yusufkarabocekz/bldc-motor-driver/BLDC Motor Driver.kicad_pcb

## KiCad design BLDC Motor Driver.kicad_pcb (2025-06-13)

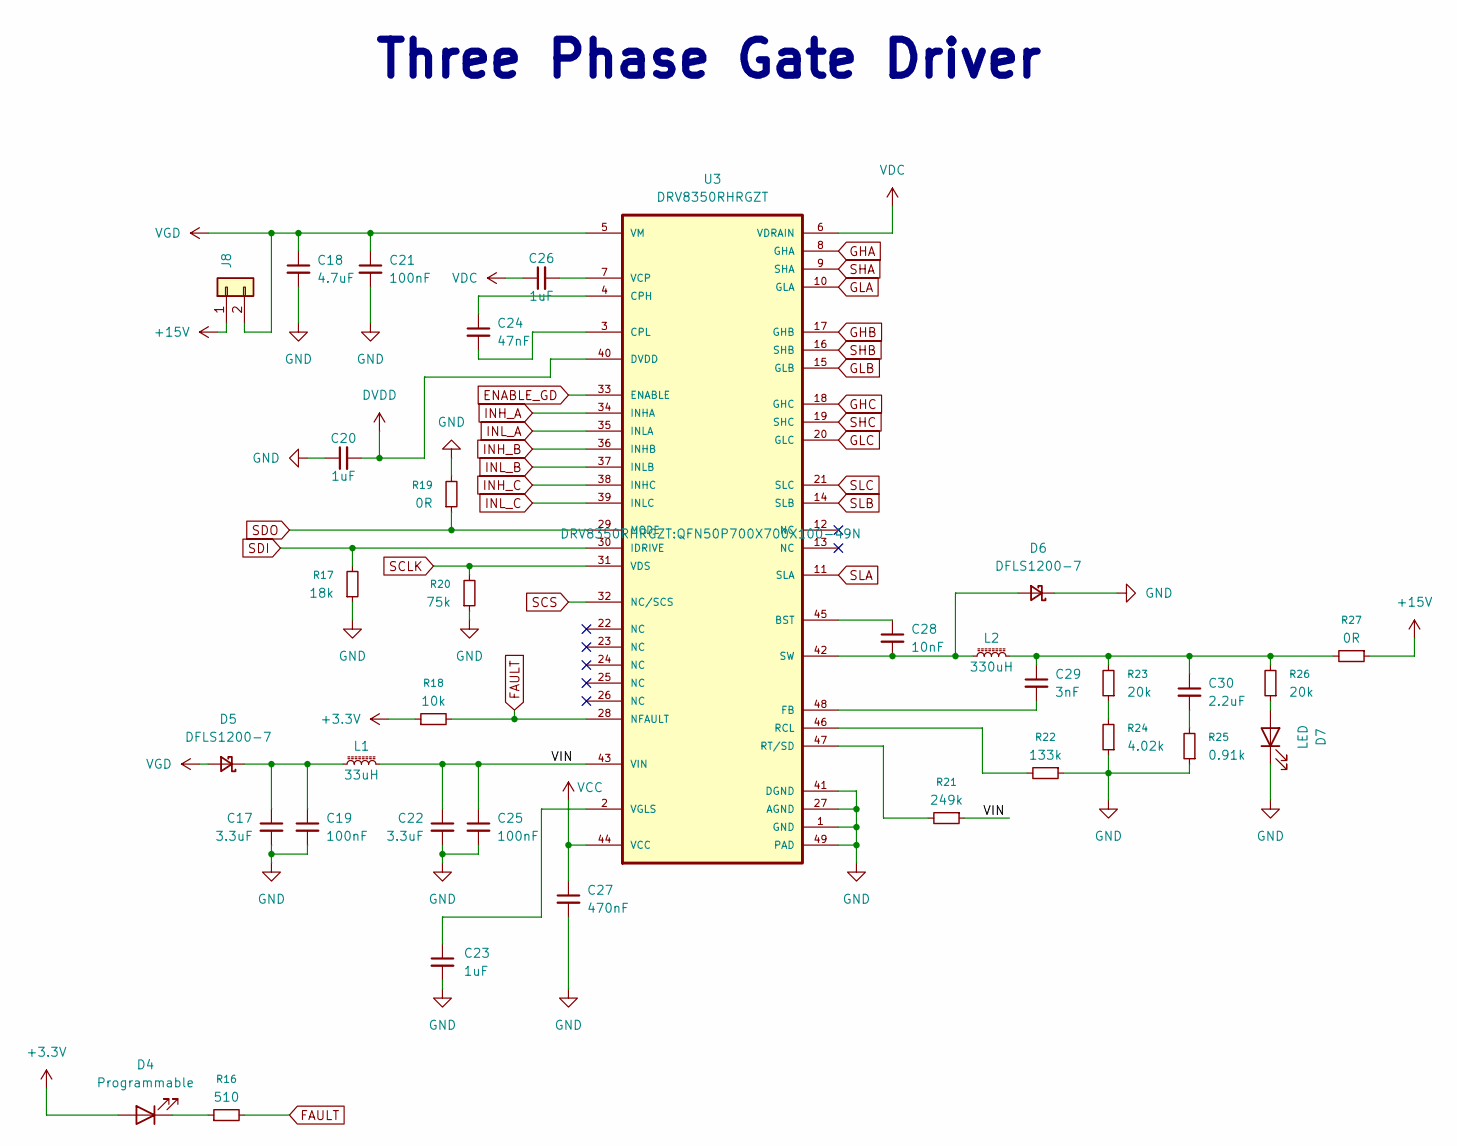
[picture p1: schematic motor_control.kicad_sch, Three Phase Gate Driver]

Parts:
C17, C22: 3.3uF; C_1206_3216Metric
C18: 4.7uF; C_2220_5750Metric
C19, C21: 100nF; C_0603_1608Metric
C20, C23, C26: 1uF; C_0402_1005Metric
C24: 47nF; C_0805_2012Metric
C25: 100nF; C_0402_1005Metric
C27: 470nF; C_0402_1005Metric
C28: 10nF; C_0603_1608Metric
C29: 3nF; C_0603_1608Metric
C30: 2.2uF; C_0805_2012Metric
D4: Programmable; LED_0603_1608Metric
D5, D6: DFLS1200-7; Nexperia_CFP3_SOD-123W
D7: LED; LED_0603_1608Metric
J8: Conn_01x02; PinHeader_1x02_P2.54mm_Vertical
L1: 33uH; L_APV_ANR252010
L2: 330uH; L_APV_ANR6028
R16: 510; R_0402_1005Metric
R17: 18k; R_0402_1005Metric
R18: 10k; R_0402_1005Metric
R19, R27: 0R; R_0402_1005Metric
R20: 75k; R_0402_1005Metric
R21: 249k; R_0402_1005Metric
R22: 133k; R_0402_1005Metric
R23, R26: 20k; R_0402_1005Metric
R24: 4.02k; R_0402_1005Metric
R25: 0.91k; R_0402_1005Metric
U3: DRV8350RHRGZT; QFN50P700X700X100-49N

Connections:
+3.3V: D4.2 (A), R18.1; also elsewhere on the board
+15V: J8.1, R27.1; also elsewhere on the board
/3-Phase Motor Control/VIN: C22.1, C25.1, L1.2, R21.1, U3.43 (VIN)
DVDD: C20.2, U3.40 (DVDD)
ENABLE_GD: U3.33 (ENABLE); also elsewhere on the board
FAULT: R16.2, R18.2, U3.28 (NFAULT); also elsewhere on the board
GHA: U3.8 (GHA); also elsewhere on the board
GHB: U3.17 (GHB); also elsewhere on the board
GHC: U3.18 (GHC); also elsewhere on the board
GLA: U3.10 (GLA); also elsewhere on the board
GLB: U3.15 (GLB); also elsewhere on the board
GLC: U3.20 (GLC); also elsewhere on the board
INH_A: U3.34 (INHA); also elsewhere on the board
INH_B: U3.36 (INHB); also elsewhere on the board
INH_C: U3.38 (INHC); also elsewhere on the board
INL_A: U3.35 (INLA); also elsewhere on the board
INL_B: U3.37 (INLB); also elsewhere on the board
INL_C: U3.39 (INLC); also elsewhere on the board
unnamed: C29.1, C30.1, L2.2, R23.2, R26.2, R27.2
unnamed: C30.2, R25.2
unnamed: D4.1 (K), R16.1
unnamed: C17.1, C19.1, D5.1 (K), L1.1
unnamed: C28.2, D6.2 (A), L2.1, U3.42 (SW)
unnamed: D7.2 (A), R26.1
unnamed: R23.1, R24.2
unnamed: C28.1, U3.45 (BST)
unnamed: C24.1, U3.4 (CPH)
unnamed: C24.2, U3.3 (CPL)
unnamed: C29.2, U3.48 (FB)
unnamed: R22.2, U3.46 (RCL)
unnamed: R21.2, U3.47 (RT/SD)
unnamed: C26.2, U3.7 (VCP)
unnamed: C23.1, U3.2 (VGLS)
SCLK: R20.2, U3.31 (VDS); also elsewhere on the board
SCS: U3.32 (NC/SCS); also elsewhere on the board
SDI: R17.2, U3.30 (IDRIVE); also elsewhere on the board
SDO: R19.1, U3.29 (MODE); also elsewhere on the board
SHA: U3.9 (SHA); also elsewhere on the board
SHB: U3.16 (SHB); also elsewhere on the board
SHC: U3.19 (SHC); also elsewhere on the board
SLA: U3.11 (SLA), U3.14 (SLB), U3.21 (SLC); also elsewhere on the board
VCC: C27.1, U3.44 (VCC)
VDC: C26.1, U3.6 (VDRAIN); also elsewhere on the board
VGD: C18.1, C21.1, D5.2 (A), J8.2, U3.5 (VM); also elsewhere on the board

Notes on the sheet:
Three Phase Gate Driver

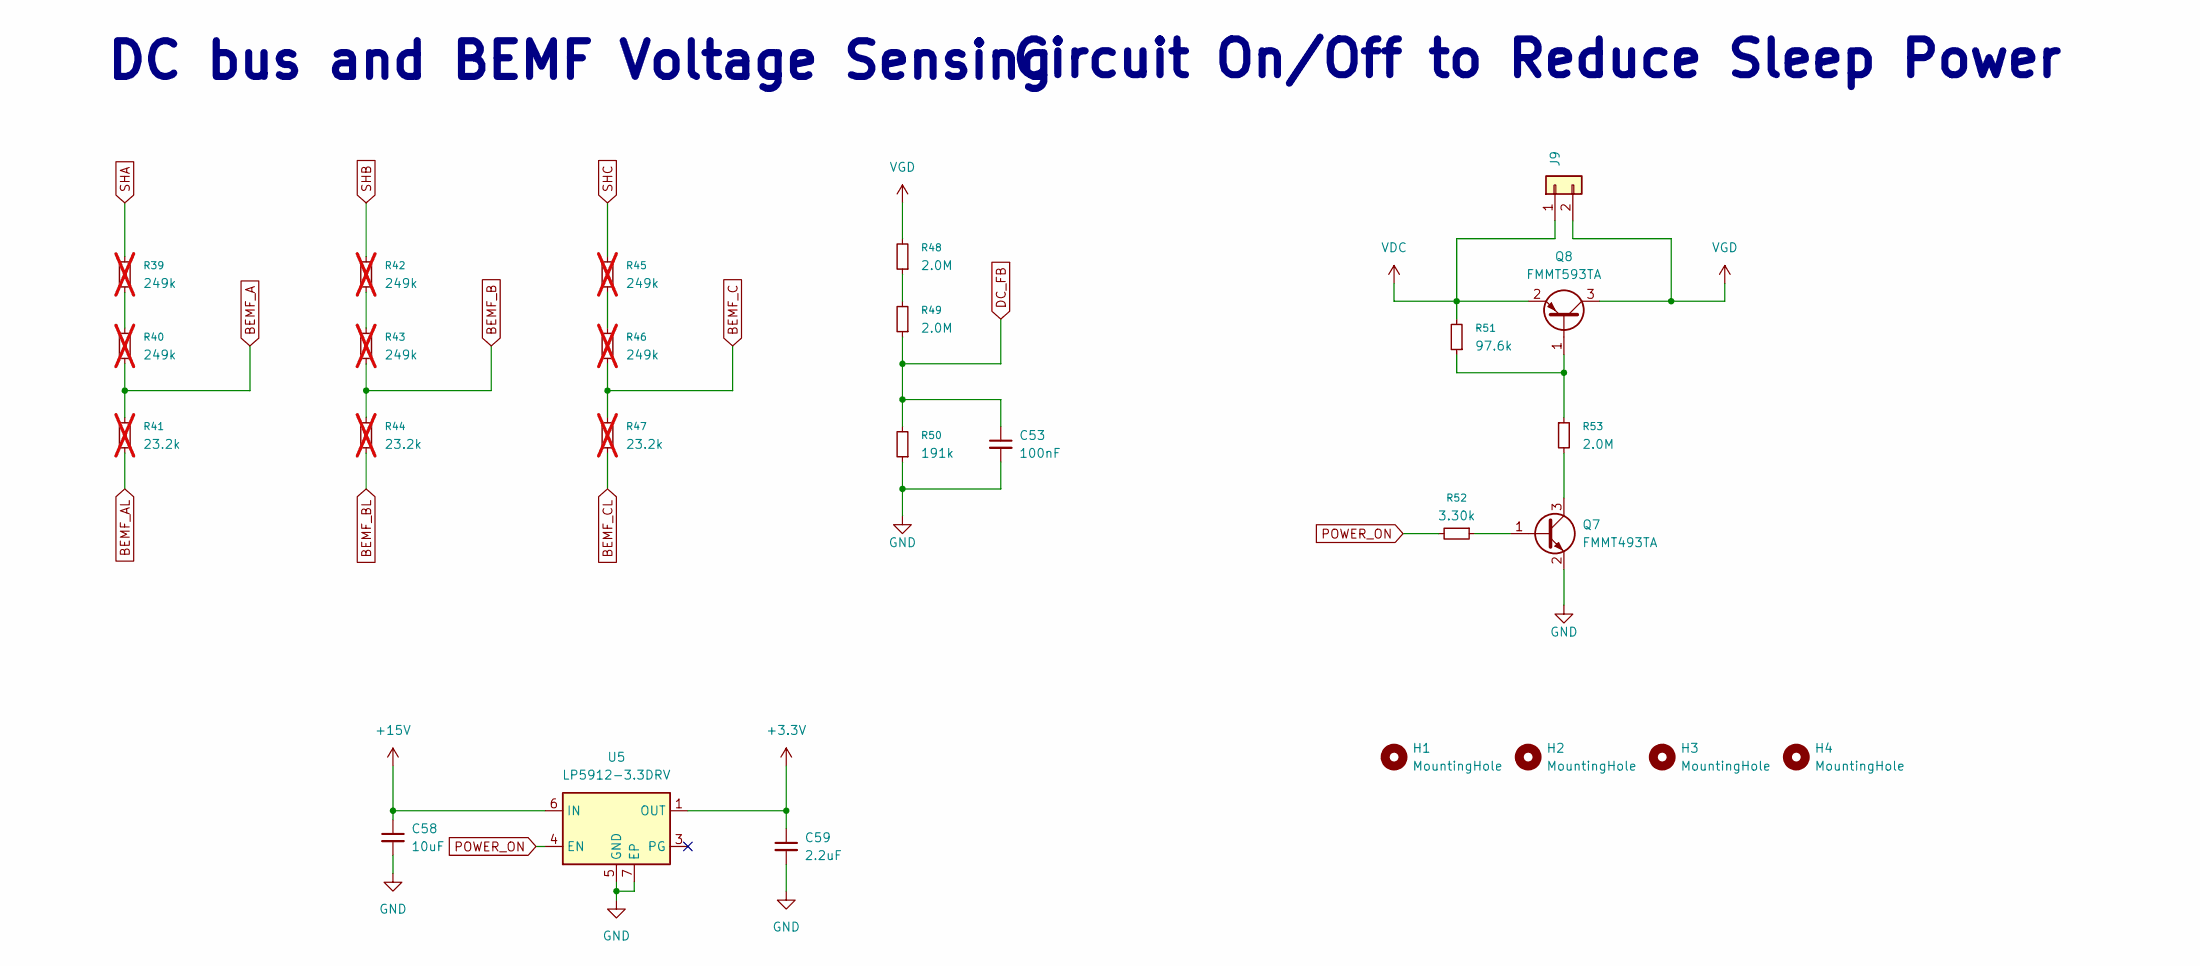
[picture p2: schematic bus_vsens_on_off.kicad_sch, DC BUS & Voltage Sens & On/Off]

Parts:
C53: 100nF; C_0402_1005Metric
C58: 10uF; C_1206_3216Metric
C59: 2.2uF; C_0402_1005Metric
H1, H2, H3, H4: MountingHole; MountingHole_3.2mm_M3_ISO14580
J9: Conn_01x02; PinHeader_1x02_P2.54mm_Vertical
Q7: FMMT493TA; SOT-23
Q8: FMMT593TA; SOT-23
R39, R40, R42, R43, R45, R46: 249k; R_0402_1005Metric; not fitted
R41, R44, R47: 23.2k; R_0402_1005Metric; not fitted
R48, R49, R53: 2.0M; R_0402_1005Metric
R50: 191k; R_0402_1005Metric
R51: 97.6k; R_0402_1005Metric
R52: 3.30k; R_0402_1005Metric
U5: LP5912-3.3DRV; WSON-6-1EP_2x2mm_P0.65mm_EP1x1.6mm_ThermalVias

Connections:
+3.3V: C59.1, U5.1 (OUT); also elsewhere on the board
+15V: C58.1, U5.6 (IN); also elsewhere on the board
BEMF_A: R40.1, R41.2; also elsewhere on the board
BEMF_AL: R41.1
BEMF_B: R43.1, R44.2; also elsewhere on the board
BEMF_BL: R44.1
BEMF_C: R46.1, R47.2; also elsewhere on the board
BEMF_CL: R47.1
DC_FB: C53.1, R49.1, R50.2; also elsewhere on the board
unnamed: Q7.1 (B), R52.1
unnamed: Q7.3 (C), R53.2
unnamed: Q8.1 (B), R51.1, R53.1
unnamed: R39.1, R40.2
unnamed: R42.1, R43.2
unnamed: R45.1, R46.2
unnamed: R48.1, R49.2
POWER_ON: R52.2, U5.4 (EN); also elsewhere on the board
SHA: R39.2; also elsewhere on the board
SHB: R42.2; also elsewhere on the board
SHC: R45.2; also elsewhere on the board
VDC: J9.1, Q8.2 (E), R51.2; also elsewhere on the board
VGD: J9.2, Q8.3 (C), R48.2; also elsewhere on the board

Notes on the sheet:
DC bus and BEMF Voltage Sensing
Circuit On/Off to Reduce Sleep Power

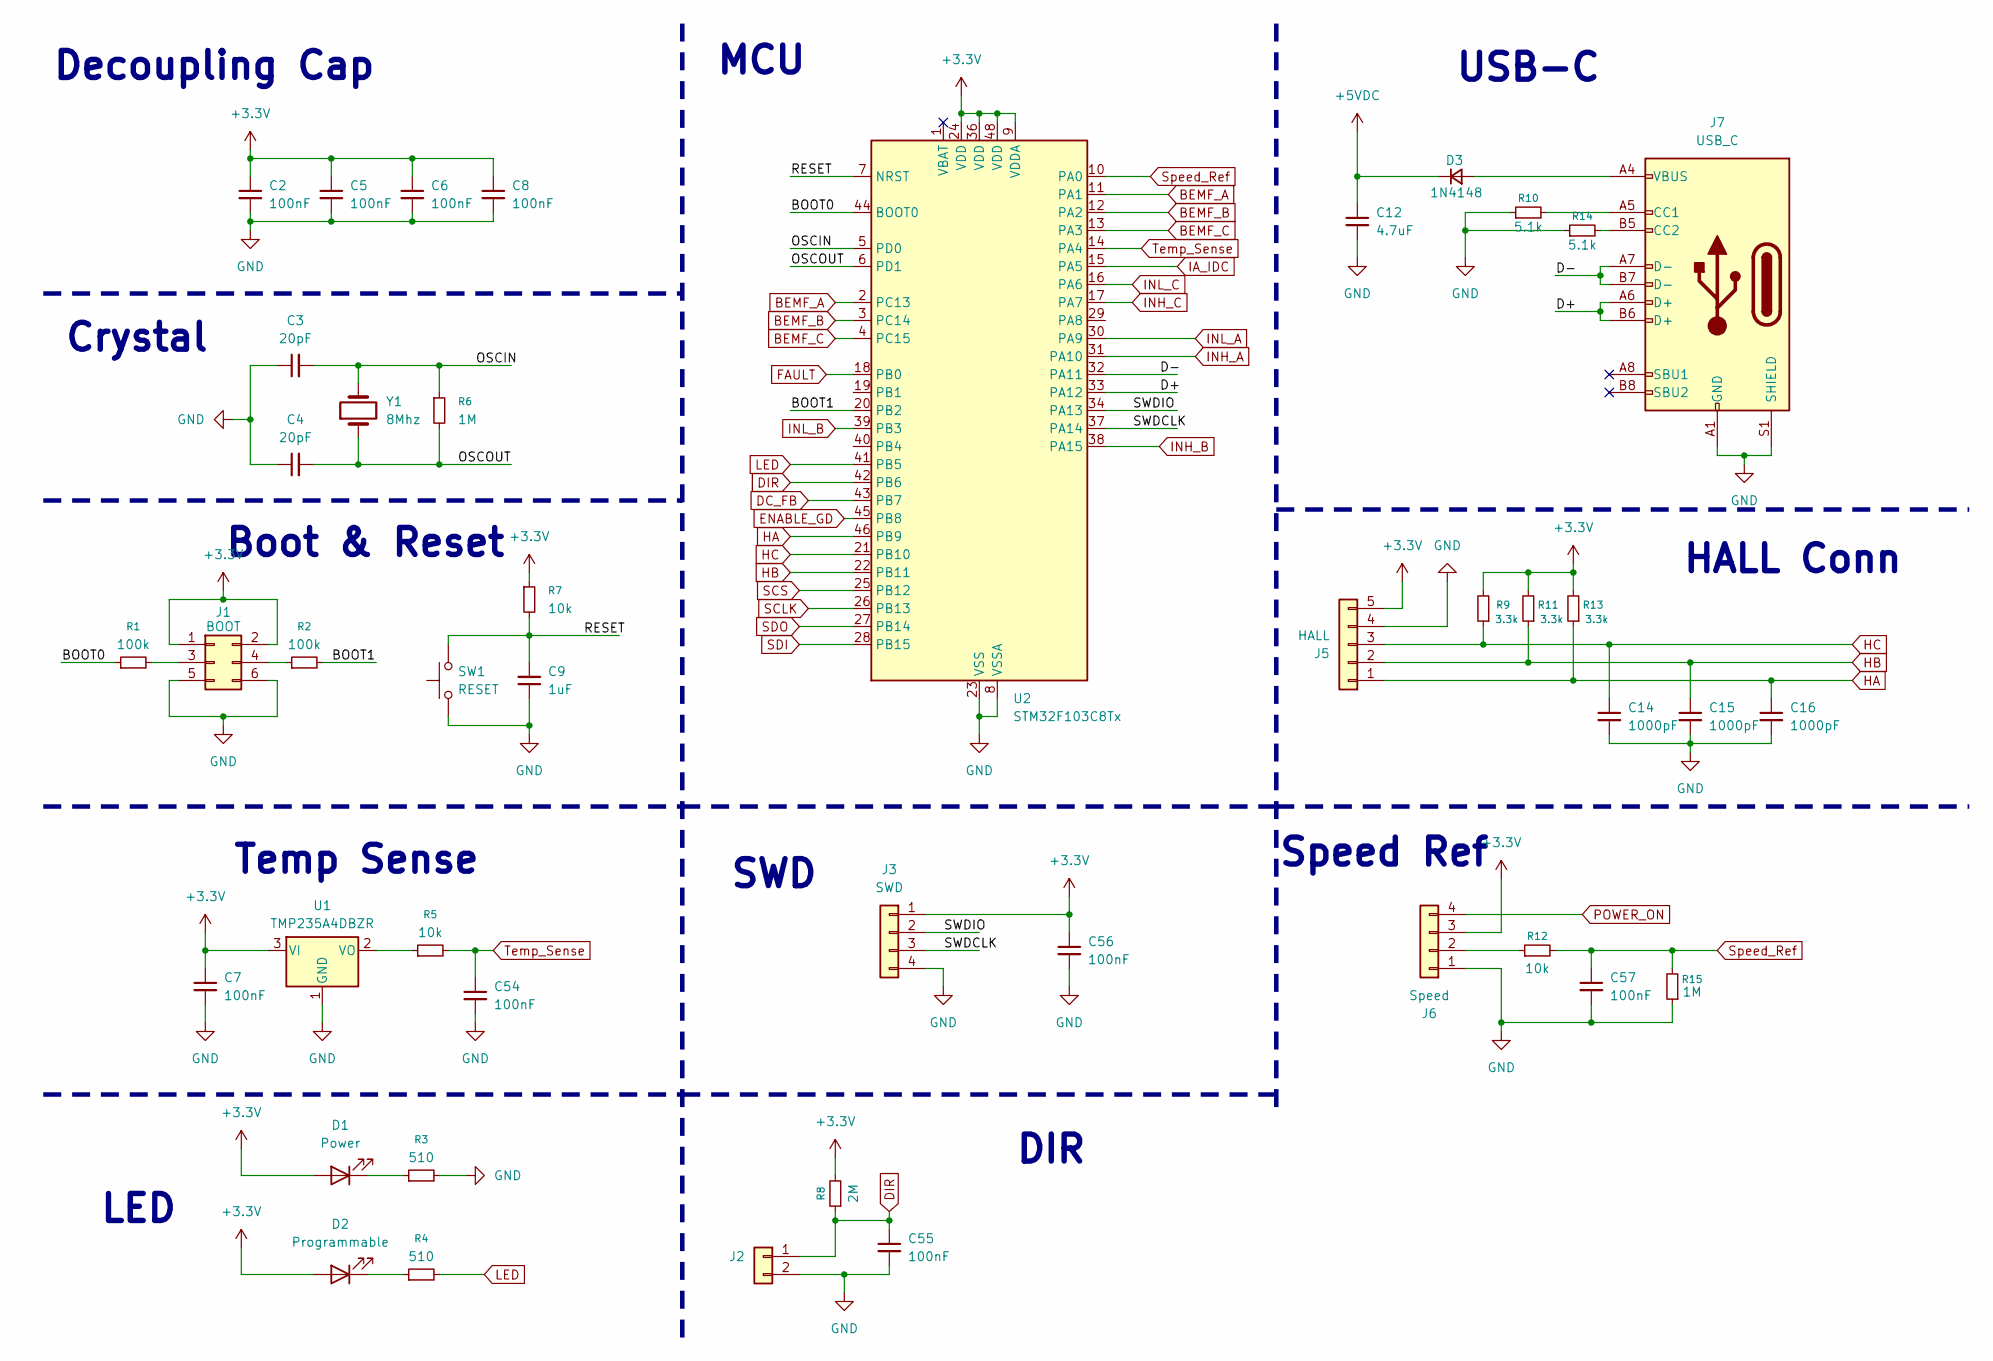
[picture p3: schematic mcu.kicad_sch, MCU and Periphs]

Parts:
C2, C5, C6, C7, C8, C54, C55, C56, C57: 100nF; C_0402_1005Metric
C3, C4: 20pF; C_0402_1005Metric
C9: 1uF; C_0402_1005Metric
C12: 4.7uF; C_0805_2012Metric
C14, C15, C16: 1000pF; C_0402_1005Metric
D1: Power; LED_0603_1608Metric
D2: Programmable; LED_0603_1608Metric
D3: 1N4148; D_SMA
J1: BOOT; PinHeader_2x03_P2.54mm_Vertical
J2: Conn_01x02; PinHeader_1x02_P2.54mm_Vertical
J3: SWD; PinHeader_1x04_P2.54mm_Vertical
J5: HALL; PinSocket_1x05_P2.54mm_Vertical
J6: Speed; PinHeader_1x04_P2.54mm_Vertical
J7: USB_C; USB_C_Receptacle_GCT_USB4105-xx-A_16P_TopMnt_Horizontal
R1, R2: 100k; R_0402_1005Metric
R3, R4: 510; R_0402_1005Metric
R5, R7, R12: 10k; R_0402_1005Metric
R6, R15: 1M; R_0402_1005Metric
R8: 2M; R_0402_1005Metric
R9, R11, R13: 3.3k; R_0402_1005Metric
R10, R14: 5.1k; R_0402_1005Metric
SW1: RESET; SW_PUSH_1P1T_6x3.5mm_H5.0_APEM_MJTP1250
U1: TMP235A4DBZR; SOT-23
U2: STM32F103C8Tx; LQFP-48_7x7mm_P0.5mm
Y1: 8Mhz; Crystal_HC18-U_Vertical

Connections:
+3.3V: C2.1, C5.1, C6.1, C7.1, C8.1, C56.1, D1.2 (A), D2.2 (A), J1.1, J1.2, J3.1, J5.5, J6.3, R7.1, R8.2, R9.2, R11.2, R13.2, U1.3 (VI), U2.9 (VDDA), U2.24 (VDD), U2.36 (VDD), U2.48 (VDD); also elsewhere on the board
+5VDC: C12.1, D3.1 (K)
/STM32F103 MCU/BOOT0: R1.1, U2.44 (BOOT0)
/STM32F103 MCU/BOOT1: R2.2, U2.20 (PB2)
/STM32F103 MCU/D+: J7.A6 (D+), J7.B6 (D+), U2.33 (PA12)
/STM32F103 MCU/D-: J7.A7 (D-), J7.B7 (D-), U2.32 (PA11)
/STM32F103 MCU/OSCIN: C3.2, R6.1, U2.5 (PD0), Y1.2
/STM32F103 MCU/OSCOUT: C4.2, R6.2, U2.6 (PD1), Y1.1
/STM32F103 MCU/SWDCLK: J3.3, U2.37 (PA14)
/STM32F103 MCU/SWDIO: J3.2, U2.34 (PA13)
BEMF_A: U2.2 (PC13), U2.11 (PA1); also elsewhere on the board
BEMF_B: U2.3 (PC14), U2.12 (PA2); also elsewhere on the board
BEMF_C: U2.4 (PC15), U2.13 (PA3); also elsewhere on the board
DC_FB: U2.43 (PB7); also elsewhere on the board
DIR: C55.1, J2.1, R8.1, U2.42 (PB6)
ENABLE_GD: U2.45 (PB8); also elsewhere on the board
FAULT: U2.18 (PB0); also elsewhere on the board
HA: C16.1, J5.1, R13.1, U2.46 (PB9)
HB: C15.1, J5.2, R11.1, U2.22 (PB11)
HC: C14.1, J5.3, R9.1, U2.21 (PB10)
IA_IDC: U2.15 (PA5); also elsewhere on the board
INH_A: U2.31 (PA10); also elsewhere on the board
INH_B: U2.38 (PA15); also elsewhere on the board
INH_C: U2.17 (PA7); also elsewhere on the board
INL_A: U2.30 (PA9); also elsewhere on the board
INL_B: U2.39 (PB3); also elsewhere on the board
INL_C: U2.16 (PA6); also elsewhere on the board
LED: R4.2, U2.41 (PB5)
unnamed: D1.1 (K), R3.1
unnamed: D2.1 (K), R4.1
unnamed: D3.2 (A), J7.A4 (VBUS), J7.A9 (VBUS), J7.B4 (VBUS), J7.B9 (VBUS)
unnamed: J1.3, R1.2
unnamed: J1.4, R2.1
unnamed: J6.2, R12.1
unnamed: J7.A5 (CC1), R10.2
unnamed: J7.B5 (CC2), R14.2
unnamed: R5.1, U1.2 (VO)
POWER_ON: J6.4; also elsewhere on the board
SCLK: U2.26 (PB13); also elsewhere on the board
SCS: U2.25 (PB12); also elsewhere on the board
SDI: U2.28 (PB15); also elsewhere on the board
SDO: U2.27 (PB14); also elsewhere on the board
Speed_Ref: C57.1, R12.2, R15.2, U2.10 (PA0)
Temp_Sense: C54.1, R5.2, U2.14 (PA4)

Notes on the sheet:
MCU
DIR
SWD
Temp Sense
Speed Ref
Crystal
HALL Conn
Boot & Reset
Decoupling Cap
LED
USB-C

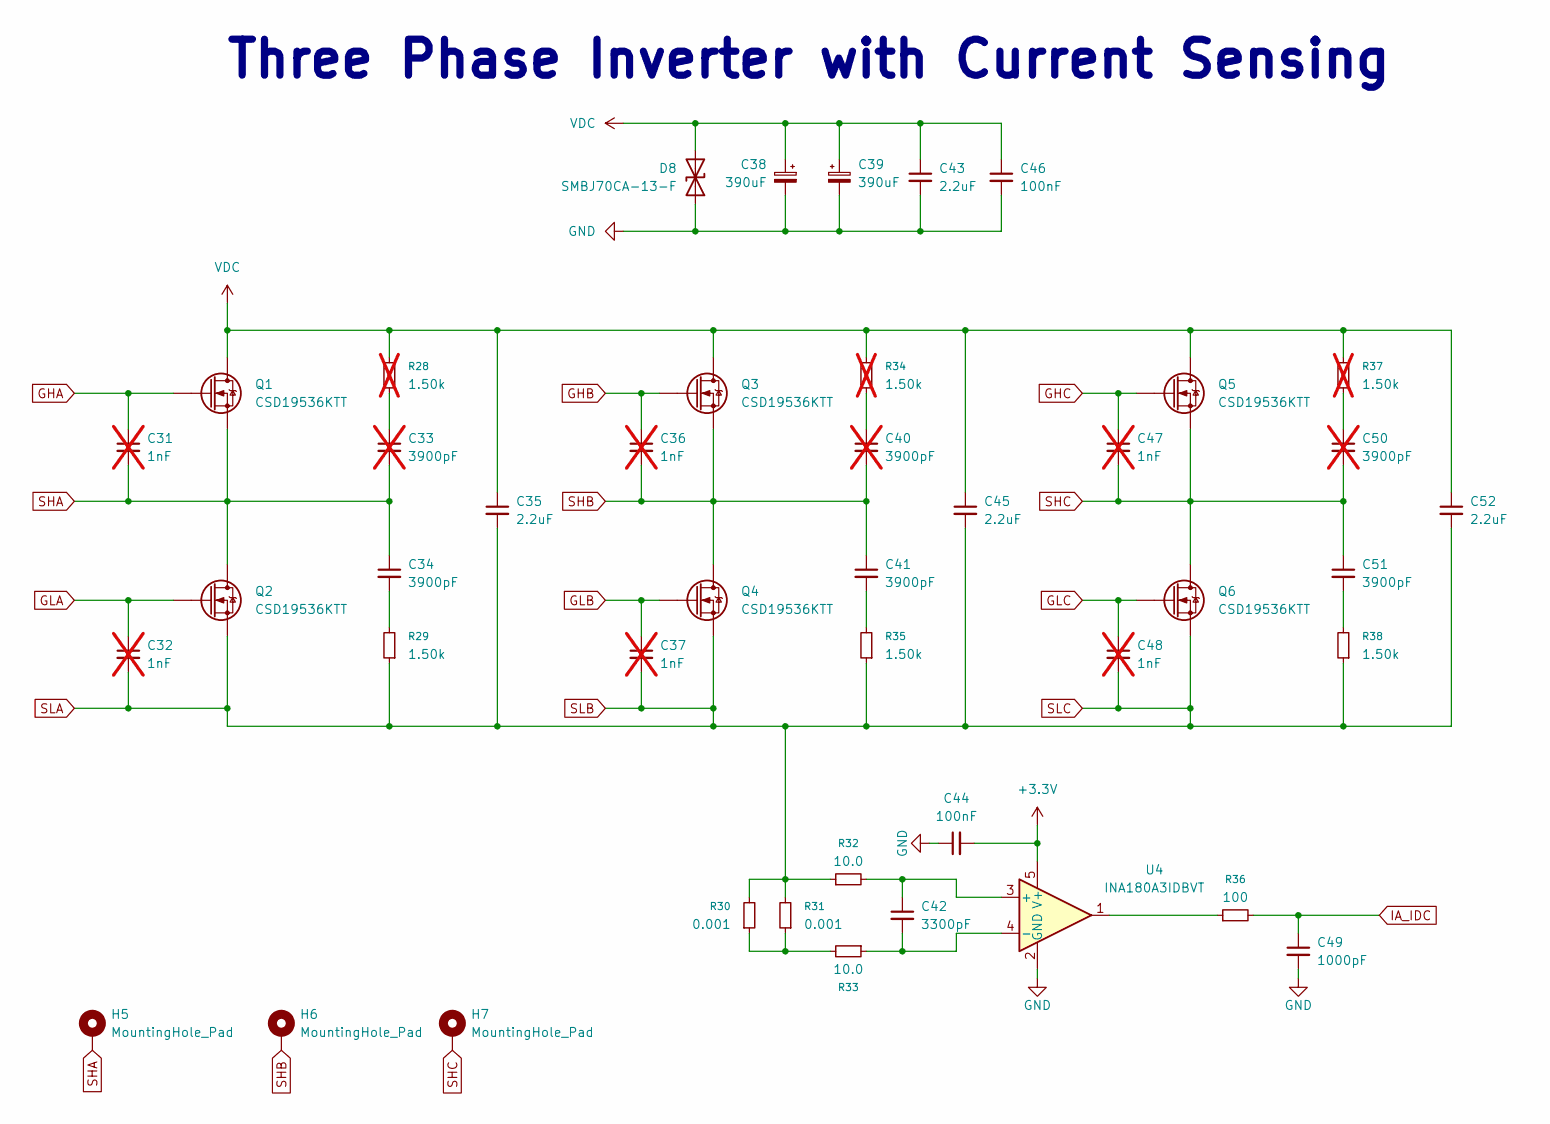
[picture p4: schematic inverter.kicad_sch, Three Phase Inverter with Current Sensing]

Parts:
C31, C32, C36, C37, C47, C48: 1nF; C_0603_1608Metric; not fitted
C33, C40, C50: 3900pF; C_1206_3216Metric; not fitted
C34, C41, C51: 3900pF; C_1206_3216Metric
C35, C43, C45, C52: 2.2uF; C_1206_3216Metric
C38, C39: 390uF; CP_Radial_D16.0mm_P7.50mm
C42: 3300pF; C_0402_1005Metric
C44: 100nF; C_0402_1005Metric
C46: 100nF; C_1206_3216Metric
C49: 1000pF; C_0402_1005Metric
D8: SMBJ70CA-13-F; D_SMB
H5, H6, H7: MountingHole_Pad; MountingHole_2.2mm_M2_Pad_Via
Q1, Q2, Q3, Q4, Q5, Q6: CSD19536KTT; TO-263-2
R28, R34, R37: 1.50k; R_1206_3216Metric; not fitted
R29, R35, R38: 1.50k; R_1206_3216Metric
R30, R31: 0.001; R_2512_6332Metric
R32, R33: 10.0; R_0402_1005Metric
R36: 100; R_0402_1005Metric
U4: INA180A3IDBVT; SOT-23-5

Connections:
+3.3V: C44.2, U4.5 (V+); also elsewhere on the board
GHA: C31.1, Q1.1 (G); also elsewhere on the board
GHB: C36.1, Q3.1 (G); also elsewhere on the board
GHC: C47.1, Q5.1 (G); also elsewhere on the board
GLA: C32.1, Q2.1 (G); also elsewhere on the board
GLB: C37.1, Q4.1 (G); also elsewhere on the board
GLC: C48.1, Q6.1 (G); also elsewhere on the board
IA_IDC: C49.1, R36.2; also elsewhere on the board
unnamed: C33.1, R28.1
unnamed: C34.2, R29.2
unnamed: C40.1, R34.1
unnamed: C41.2, R35.2
unnamed: C50.1, R37.1
unnamed: C51.2, R38.2
unnamed: R30.1, R31.1, R33.2
unnamed: R36.1, U4.1
unnamed: C42.1, R32.2, U4.3 (+)
unnamed: C42.2, R33.1, U4.4 (-)
SHA: C31.2, C33.2, C34.1, H5.1, Q1.3 (S), Q2.2 (D); also elsewhere on the board
SHB: C36.2, C40.2, C41.1, H6.1, Q3.3 (S), Q4.2 (D); also elsewhere on the board
SHC: C47.2, C50.2, C51.1, H7.1, Q5.3 (S), Q6.2 (D); also elsewhere on the board
SLA: C32.2, C35.2, C37.2, C45.2, C48.2, C52.2, Q2.3 (S), Q4.3 (S), Q6.3 (S), R29.1, R30.2, R31.2, R32.1, R35.1, R38.1; also elsewhere on the board
VDC: C35.1, C38.1, C39.1, C43.1, C45.1, C46.1, C52.1, D8.2 (A2), Q1.2 (D), Q3.2 (D), Q5.2 (D), R28.2, R34.2, R37.2; also elsewhere on the board

Notes on the sheet:
Three Phase Inverter with Current Sensing

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
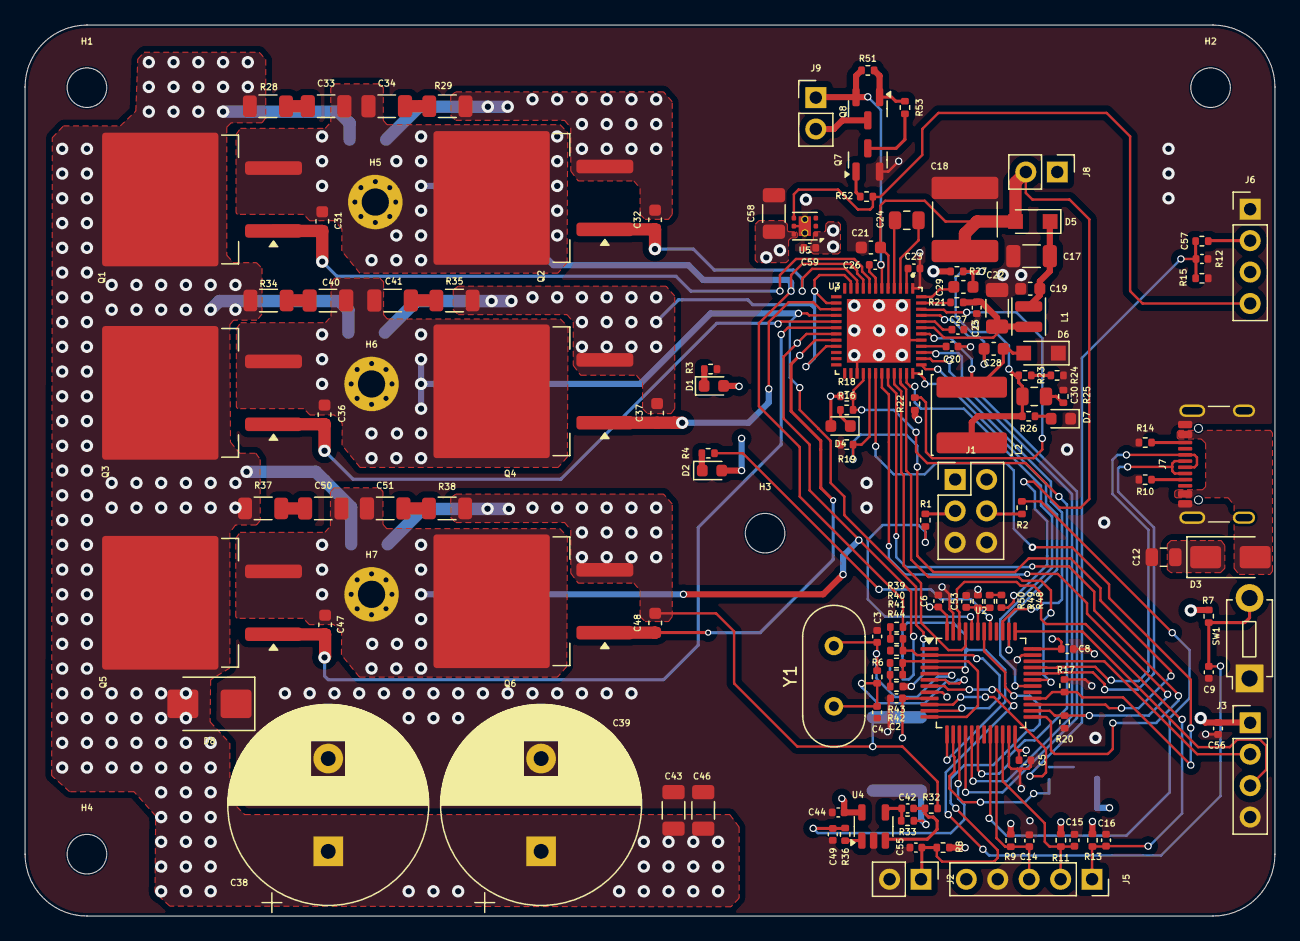
[picture p5: board BLDC Motor Driver.kicad_pcb from above]

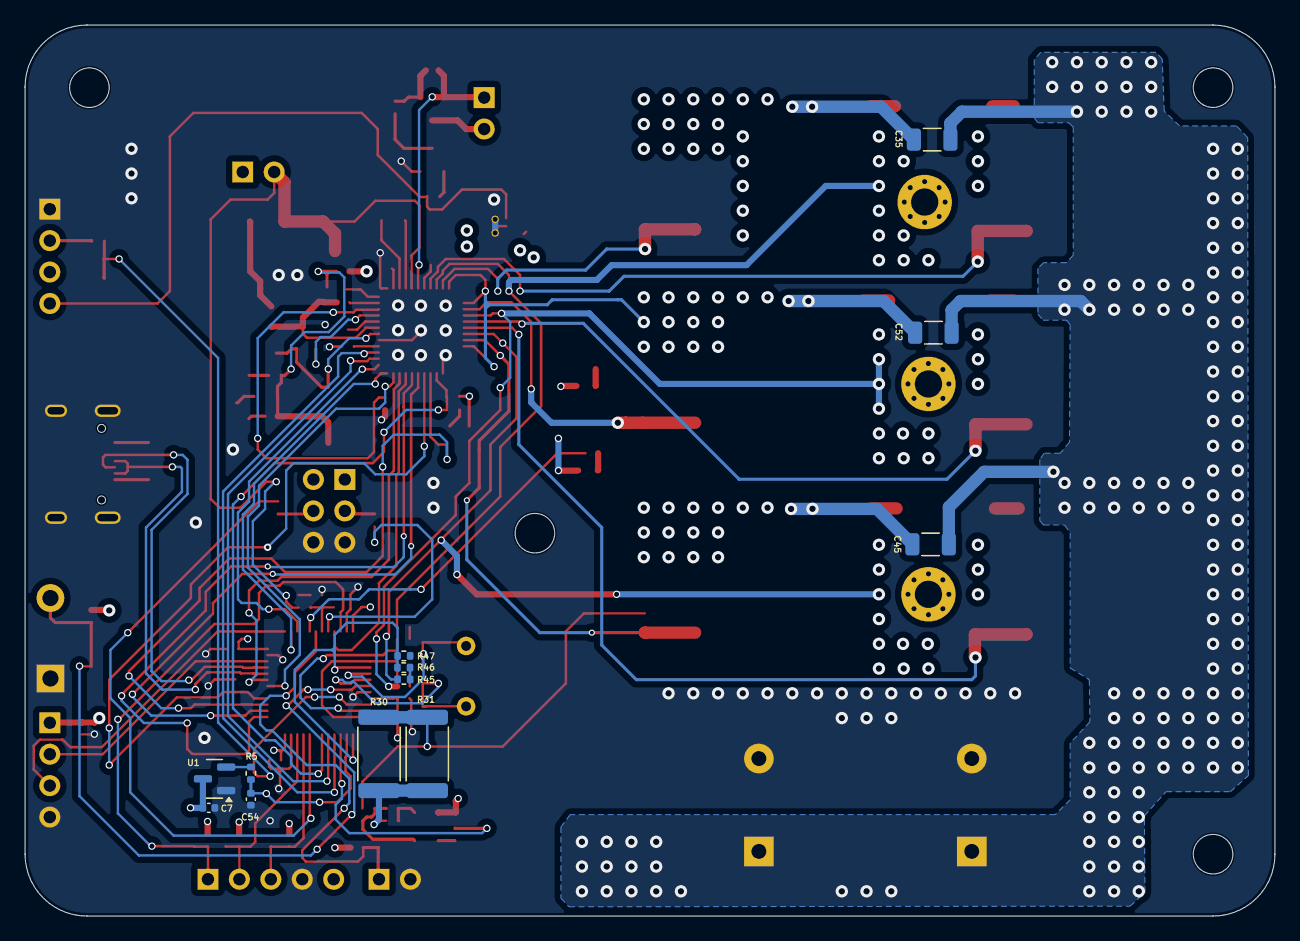
[picture p6: board BLDC Motor Driver.kicad_pcb from below]

Board: 4 copper layers, 101.0 x 72.0 mm, 148 parts (12 on the bottom side), 94 nets.
