yusufkarabocekz/bldc-motor-driver/(commit log)

2025-06-10 3 phase gate driver schematic
    [BLDC Motor Driver.kicad_pcb, BLDC Motor Driver.kicad_sch, mcu.kicad_sch, motor_control.kicad_sch]
2025-06-11 schematic finished
    [BLDC Motor Driver.kicad_pcb, BLDC Motor Driver.kicad_sch, bus_vsens_on_off.kicad_sch, inverter.kicad_sch, mcu.kicad_sch, motor_control.kicad_sch]
2025-06-12 some routing processing
    [BLDC Motor Driver.kicad_pcb, bus_vsens_on_off.kicad_sch, inverter.kicad_sch, mcu.kicad_sch, motor_control.kicad_sch]
2025-06-13 finished the pcb design
    [BLDC Motor Driver.kicad_pcb]
